BrianCKWang/airhockey-table-robot/README.md

# airhockey-table-robot

## Machine Rendering:
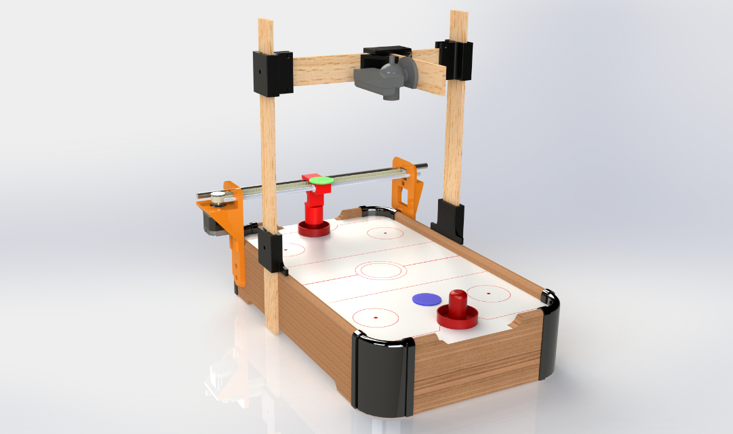
[picture p1: assets/files/main-img-01.png]
main pic1

## Communication Interface (C#)
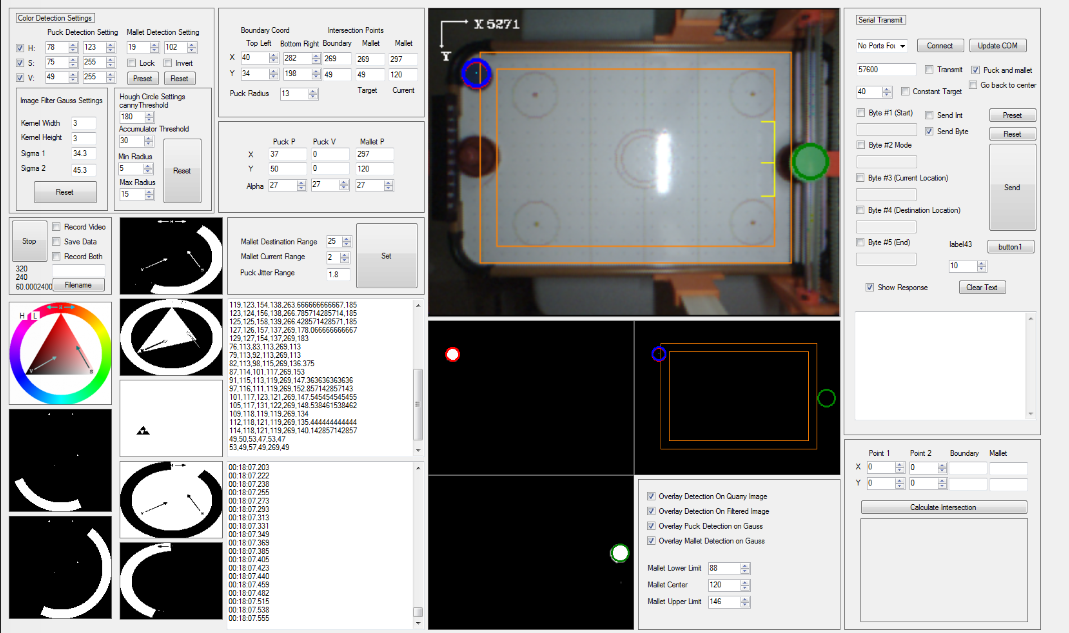
[picture p2: assets/files/main-img-02.png]
main pic2


## Objective
### The project includes a vision system and motor control system to control an air hockey mallet  in order to deflect the air hockey puck. 

## Technology
 - C# with EMGU CV .NET library
 - Arduino
 - A4988 Stepper Motor Driver
 
[Link to Live Demo Video](https://www.youtube.com/watch?v=BS8QJHVgoiw)
