BrianCKWang/airhockey-table-robot/Vision/CameraCapture EMGU 3_1/CameraCapture/bin/Debug/HSV-wheel.png

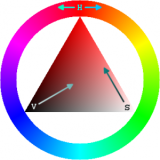
Vision/CameraCapture EMGU 3_1/CameraCapture/bin/Debug/HSV-wheel.png
