BrianCKWang/airhockey-table-robot/(threads)

Thread 1 (2024-06-07):

Arduino Code not working possibly incomple

nilsbeet, 2024-06-07:
Some functions of the C++ Arduino code to run the stepper motor seem to be not defined /declared. Causes whole code to not work.

BrianCKWang, 2024-06-10:
Could you provide more detail on which functions are not defined/declared?

nilsbeet, 2024-06-11:
Nevermind, it compiled successfully, when I tried to run it

Closed 2024-06-11.
