BrianCKWang/airhockey-table-robot/(commit log)

2021-01-04 push local repo
    [1.csv, 10.csv, 11.csv, 12.csv, 13.csv, 14.csv, 2.csv, 3.csv]
2021-01-04 fix arduino code path
    [MECH423_Stepper_Motor_Control.ino]
